scrapcomputing/nwX287.cr2032.ssop.mot/kicad/nwX287.kicad_pcb

## KiCad design kicad/nwX287.kicad_pcb (2023-07-23)

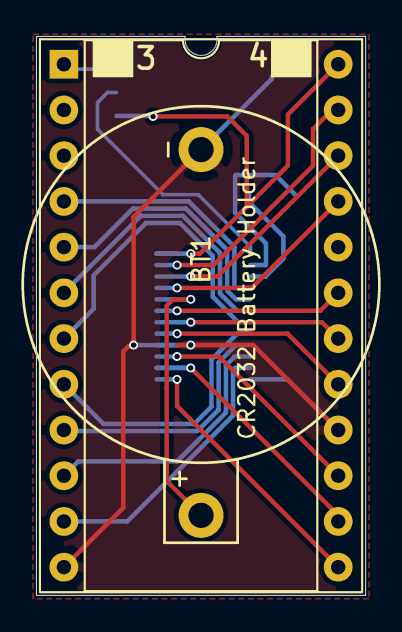
[picture p4: board nwX287.kicad_pcb from above]

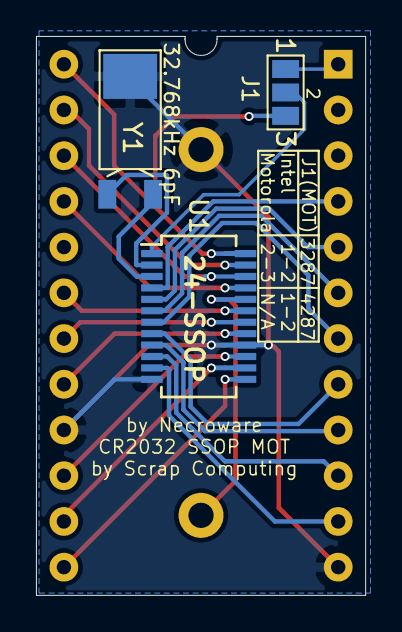
[picture p5: board nwX287.kicad_pcb from below]

Board: 2 copper layers, 18.3 x 31.1 mm, 5 parts (3 on the bottom side), 24 nets.

Parts:
BT1: CR2032; CR2032_battery_holder
J1: Conn_01x03_Male; SolderJumper-3_P1.3mm_Open_Pad1.0x1.5mm_NumberLabels
U1: bq4285; SSOP-24_3.9x8.7mm_P0.635mm
U2: socket; DIP-24_W15.24mm_Socket
Y1: 32.768kHz 6pF; Crystal_SMD_FrontierElectronics_FM206

Connections:
AD0: U1.4, U2.4
AD1: U1.5, U2.5
AD2: U1.6, U2.6
AD3: U1.7, U2.7
AD4: U1.8, U2.8
AD5: U1.9, U2.9
AD6: U1.10, U2.10
AD7: U1.11, U2.11
AS: U1.14, U2.14
BC: BT1.1, U1.20
CEI: U1.21, U2.21
CEO: U1.22, U2.22
CS: U1.13, U2.13
DS: U1.17, U2.17
GND: BT1.2, U1.12, U1.16, U2.12, U2.16, Y1.3
INT: U1.19, U2.19
unnamed: J1.2, U1.1
RST: U1.18, U2.18
RW: U1.15, U2.15
SQW: U1.23, U2.23
VCC: J1.3, U1.24, U2.24
VOUT: J1.1, U2.1
X1: U1.2, Y1.2
X2: U1.3, Y1.1
